Mgaete2905/TEI201-Grupo-3/hardware/esquemas/esquema_prototipo_1.png

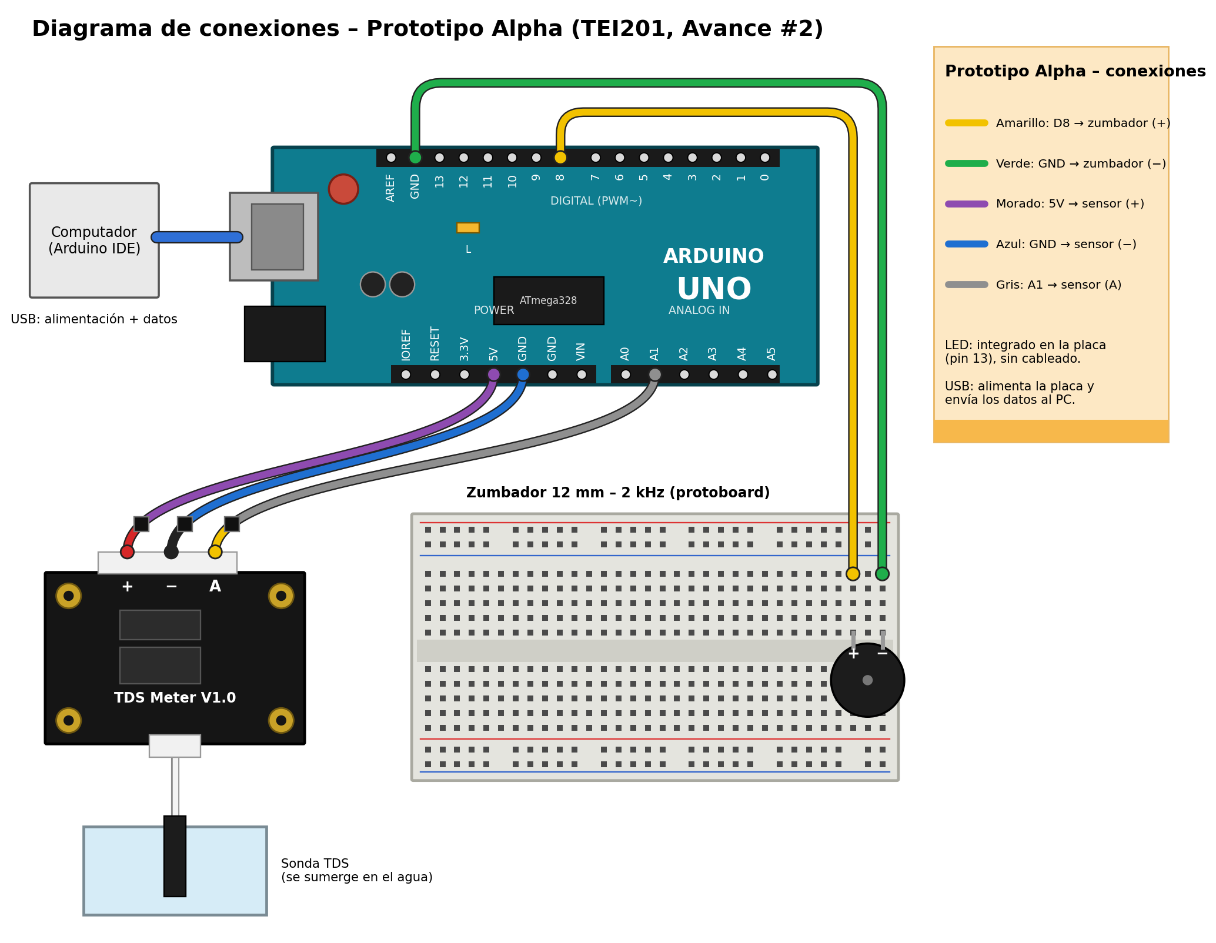
hardware/esquemas/esquema_prototipo_1.png
