Mgaete2905/TEI201-Grupo-3/diseno_3d/fusion360/ensamble_nodo.step

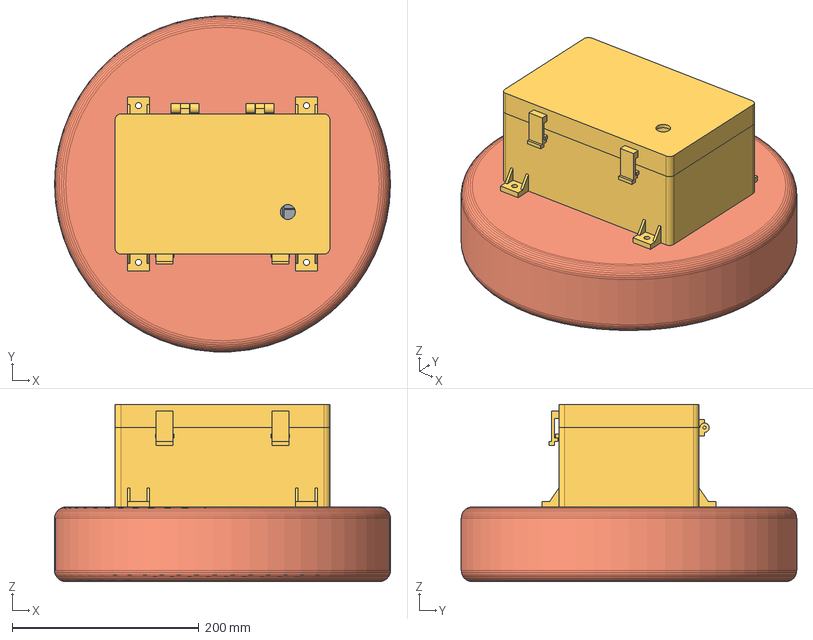
[picture p13: CAD file, 2026-10-26]
diseno_3d/fusion360/ensamble_nodo.step
360.0 x 359.5 x 190.0 mm
cofre_base
tapa
bandeja
boya_plana
ref_Arduino_Uno
ref_Protoboard_400
ref_Portapilas_2x18650
ref_Placa_TDS
ref_Silica_gel
ref_ESP32
