Mgaete2905/TEI201-Grupo-3/diseno_3d/fusion360/bandeja.step

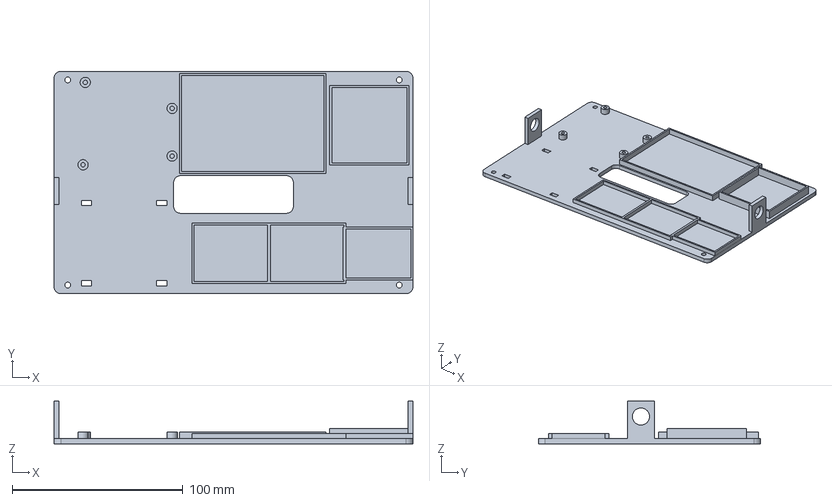
[picture p14: CAD file, 2026-10-26]
diseno_3d/fusion360/bandeja.step
210.0 x 130.0 x 25.0 mm
