Mgaete2905/TEI201-Grupo-3/diseno_3d/fusion360/tapa.step

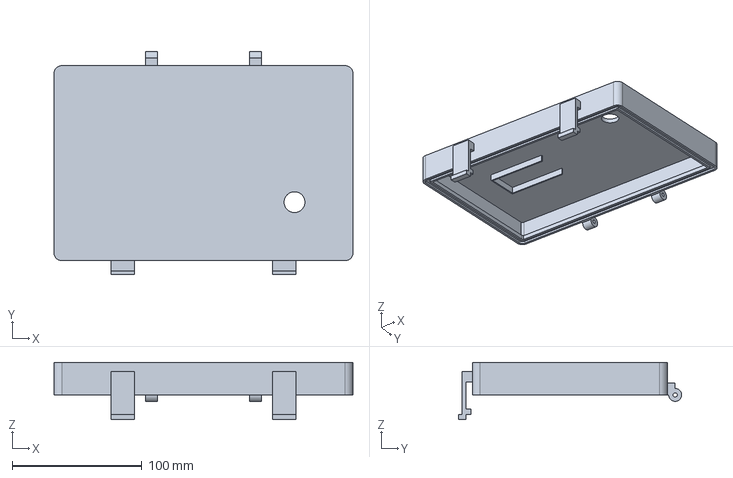
[picture p15: CAD file, 2026-10-26]
diseno_3d/fusion360/tapa.step
230.0 x 171.7 x 44.0 mm
