Mgaete2905/TEI201-Grupo-3/diseno_3d/fusion360/cofre_base.step

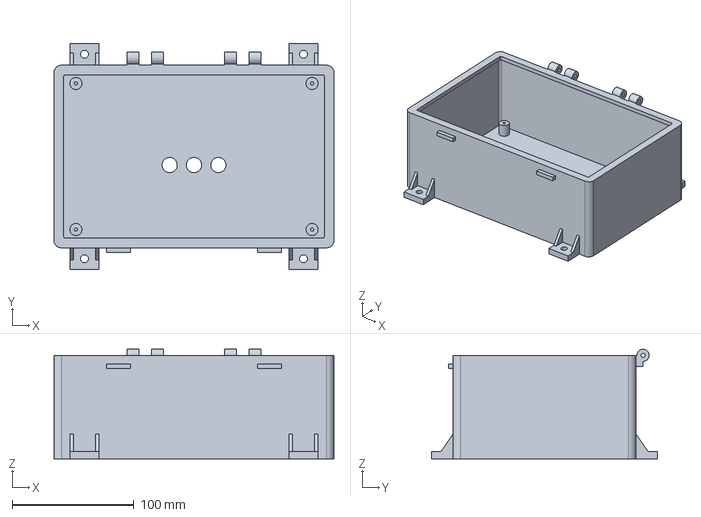
[picture p16: CAD file, 2026-10-26]
diseno_3d/fusion360/cofre_base.step
230.0 x 186.0 x 90.0 mm
