Mgaete2905/TEI201-Grupo-3/diseno_3d/fusion360/boya_plana.step

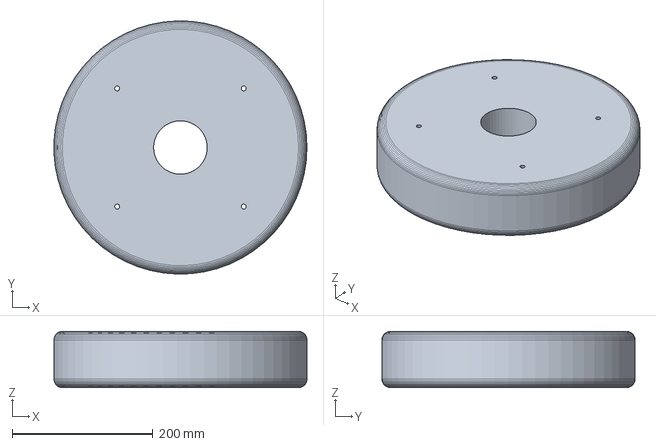
[picture p17: CAD file, 2026-10-26]
diseno_3d/fusion360/boya_plana.step
359.7 x 359.9 x 80.0 mm
