Mgaete2905/TEI201-Grupo-3/(list of files, cad)

Other CAD files:
diseno_3d/fusion360/imprimir_cofre_base.stl
diseno_3d/fusion360/imprimir_tapa.stl
diseno_3d/fusion360/imprimir_bandeja.stl
