Mgaete2905/TEI201-Grupo-3/diseno_3d/planos/planos_encapsulado.pdf

## Nodo flotante TDS · Encapsulado

Pieza: Conjunto | Material: varios
Escala sin escala · unidades mm | TEI201 UAI · 18-10-2026 · Hoja 1/4

# Conjunto general y lista de materiales

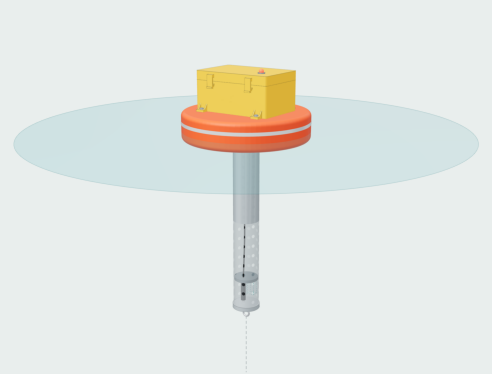
[picture p18: figure]

Medidas generales: cofre 230 × 150 × 110 (186 de ancho con orejas) · boya Ø360 × 80 · tubo Ø75 × 500 · alto total ≈ 690 · electrónica sobre la línea de flotación.

Pos. | Componente | Cant. | Especificación
1 | Cofre (base) | 1 | Impreso PETG/ASA, 4 perímetros, 100 % relleno
2 | Tapa con bisagra y pestillos | 1 | Impresa PETG/ASA, se imprime boca abajo
3 | Bandeja | 1 | Impresa PETG o PLA (zona seca)
4 | Empaque de cierre | 0,75 m | Cordón silicona/EPDM Ø4 (o burlete EPDM 4 mm)
5 | Prensaestopas PG7 IP68 | 3 | Cable Ø3–6,5; 2 con tapón ciego
6 | Piloto LED estanco 16 mm | 1 | IP67, versión 5 V, con tuerca y junta
7 | Tornillo M3 × 8 autorroscante | 8 | 4 bandeja + 4 Arduino (acero inox.)
8 | Tornillo M3 × 35 + tuerca autoblocante | 2 | Ejes de bisagra (acero inox.)
9 | Perno M6 × 100 + tuerca + golillas | 4 | Fijación a la boya (acero inox. 316)
10 | Bridas plásticas 2,5 × 100 | 2 | Sujetan el portapilas
11 | Cinta doble faz | 1 | Bajo el portapilas y la protoboard
12 | Sílica gel | 1 | Bolsa 10–20 g, cambiar al abrir
13 | Boya plana Ø≈360 | 1 | Comprada (HDPE/espuma) y perforada
14 | Tubo PVC hidráulico Ø75 | 0,5 m | Perforado Ø10 en la parte baja

Electrónica (no impresa): Arduino Uno, protoboard 400, portapilas 2×18650, placa TDS, ESP32, sonda TDS.

# Cofre (base)

### PLANTA (vista superior)

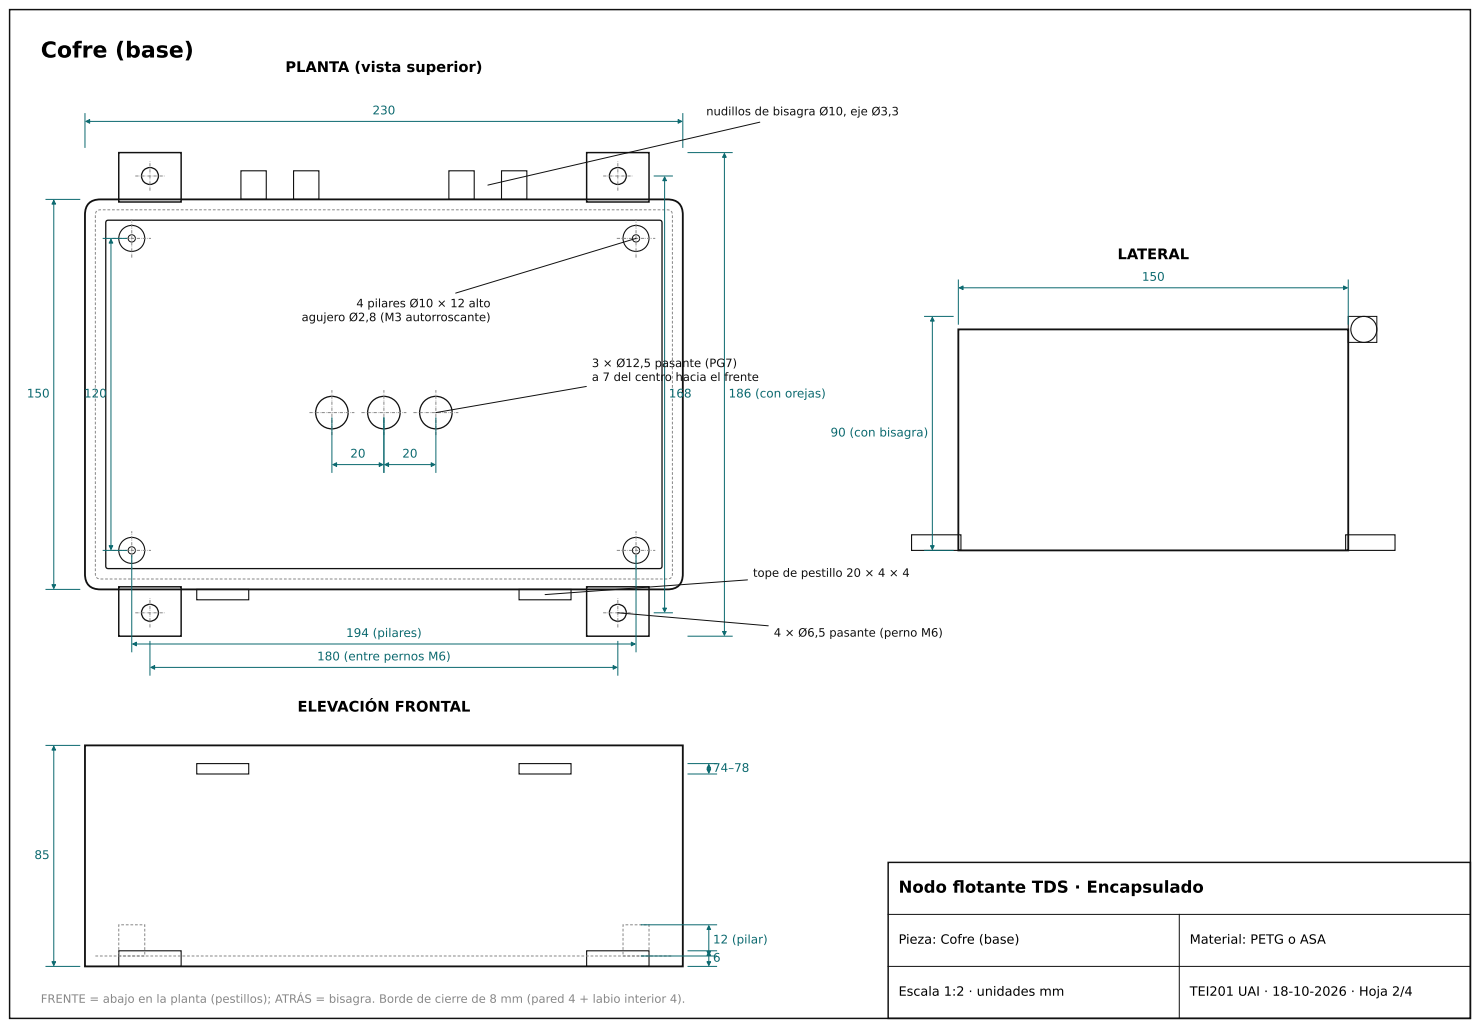
[picture p19: page 2]
Pieza: Cofre (base); Material: PETG o ASA; Escala 1:2 · unidades mm; TEI201 UAI · 18-10-2026 · Hoja 2/4; 186 (con orejas); 180 (entre pernos M6); 194 (pilares); 4 × Ø6,5 pasante (perno M6); 4 pilares Ø10 × 12 alto agujero Ø2,8 (M3 autorroscante); ELEVACIÓN FRONTAL; 12 (pilar); LATERAL; 90 (con bisagra)

nudillos de bisagra Ø10, eje Ø3,3

3 × Ø12,5 pasante (PG7)
a 7 del centro hacia el frente

tope de pestillo 20 × 4 × 4

Nodo flotante TDS · Encapsulado

FRENTE = abajo en la planta (pestillos); ATRÁS = bisagra. Borde de cierre de 8 mm (pared 4 + labio interior 4).

# Tapa con bisagra, pestillos y ranura de empaque

### PLANTA (vista superior)

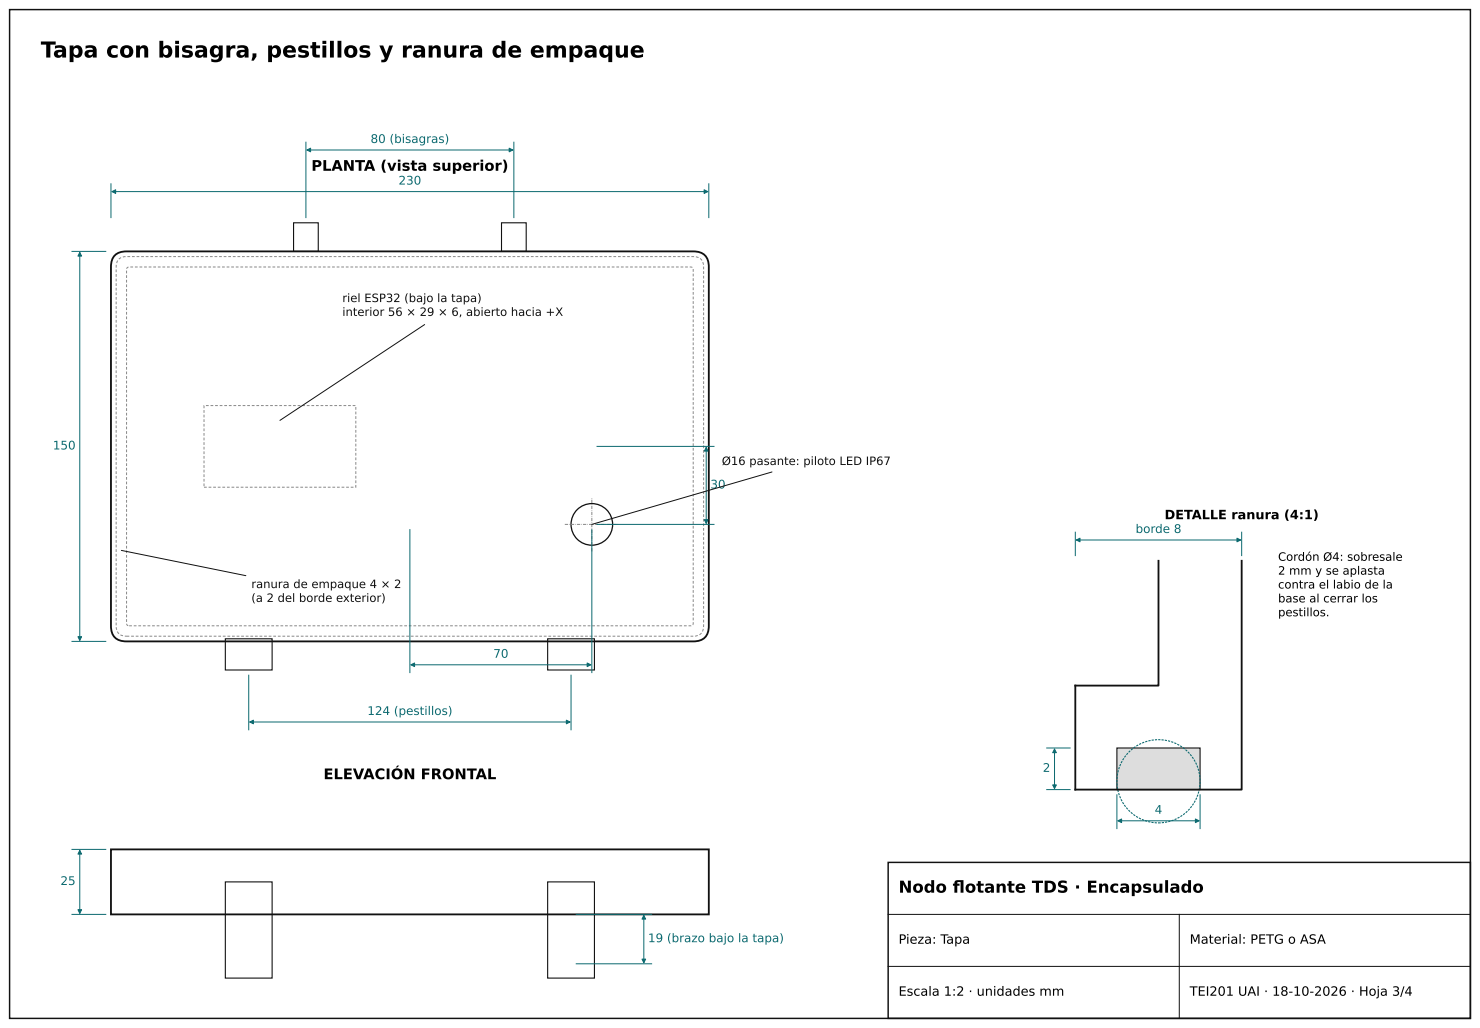
[picture p20: page 3]
Pieza: Tapa; Material: PETG o ASA; 124 (pestillos); 80 (bisagras); ELEVACIÓN FRONTAL; DETALLE ranura (4:1); borde 8

riel ESP32 (bajo la tapa)
interior 56 × 29 × 6, abierto hacia +X

Ø16 pasante: piloto LED IP67

Cordón Ø4: sobresale
2 mm y se aplasta
contra el labio de la
base al cerrar los
pestillos.

ranura de empaque 4 × 2
(a 2 del borde exterior)

Nodo flotante TDS · Encapsulado

19 (brazo bajo la tapa)

# Bandeja removible y fijación de componentes

### PLANTA (vista superior)

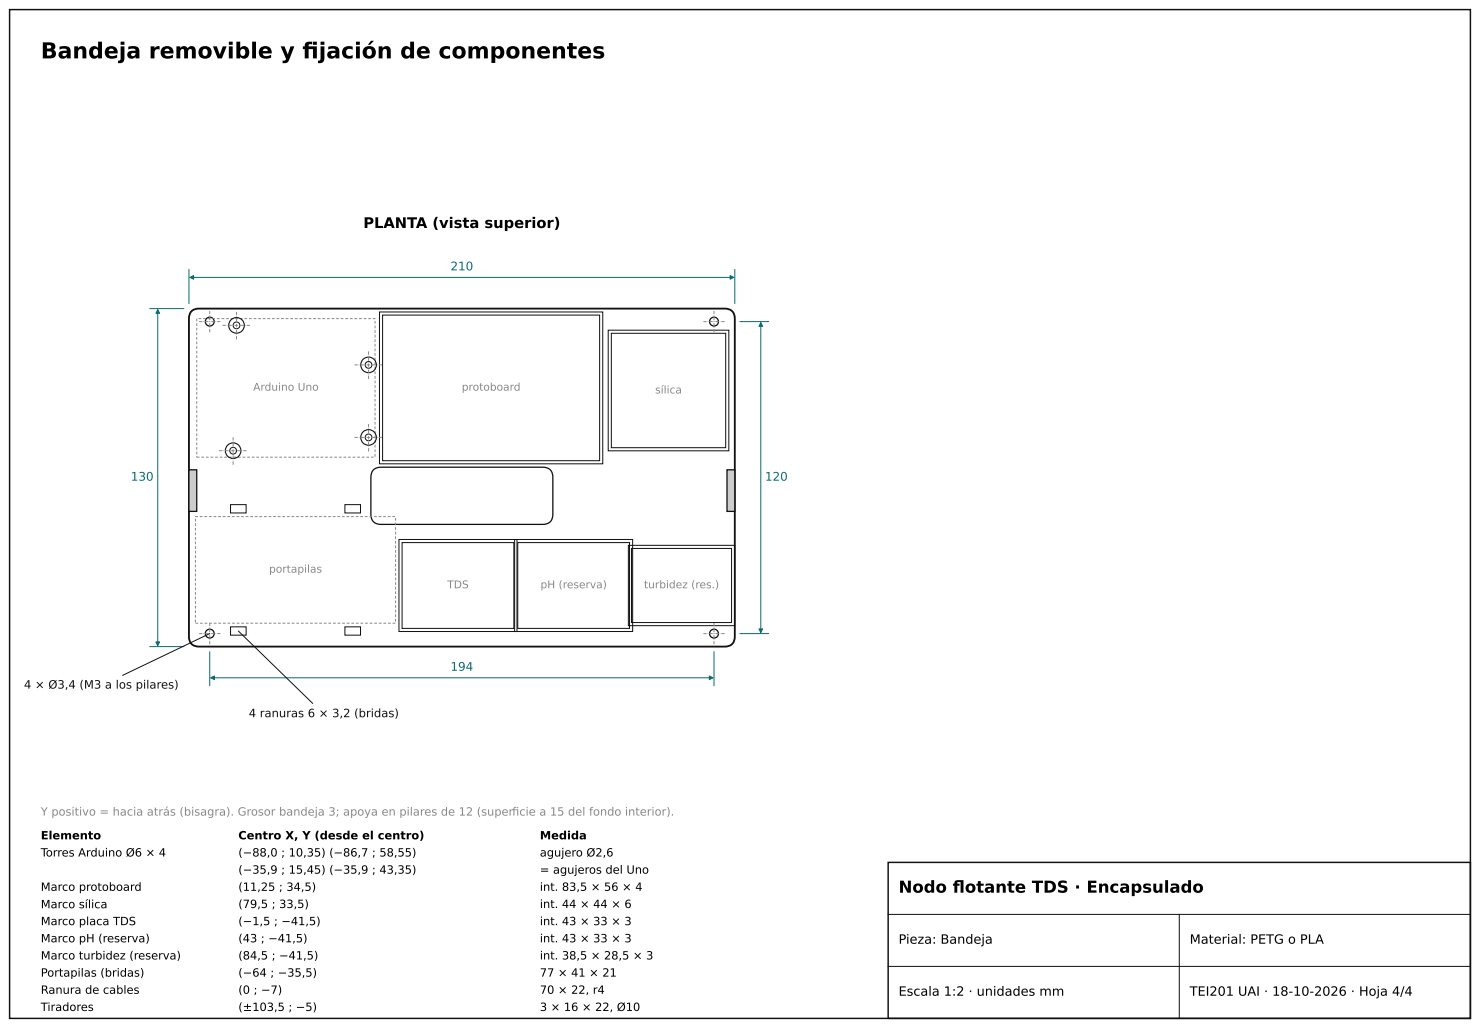
[picture p21: page 4]
Pieza: Bandeja; Material: PETG o PLA; protoboard; sílica; TDS; pH (reserva); turbidez (res.); portapilas; Arduino Uno; 4 × Ø3,4 (M3 a los pilares); 4 ranuras 6 × 3,2 (bridas); Elemento; Centro X, Y (desde el centro); Medida; Torres Arduino Ø6 × 4; agujero Ø2,6; = agujeros del Uno; Marco protoboard; int. 83,5 × 56 × 4; Marco sílica; int. 44 × 44 × 6; Marco placa TDS; int. 43 × 33 × 3; Marco pH (reserva); Marco turbidez (reserva); int. 38,5 × 28,5 × 3; Portapilas (bridas); Ranura de cables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

Y positivo = hacia atrás (bisagra). Grosor bandeja 3; apoya en pilares de 12 (superficie a 15 del fondo interior).

Nodo flotante TDS · Encapsulado
