Mgaete2905/TEI201-Grupo-3/testing/evidencias/Grafico_Prueba_Sal.png

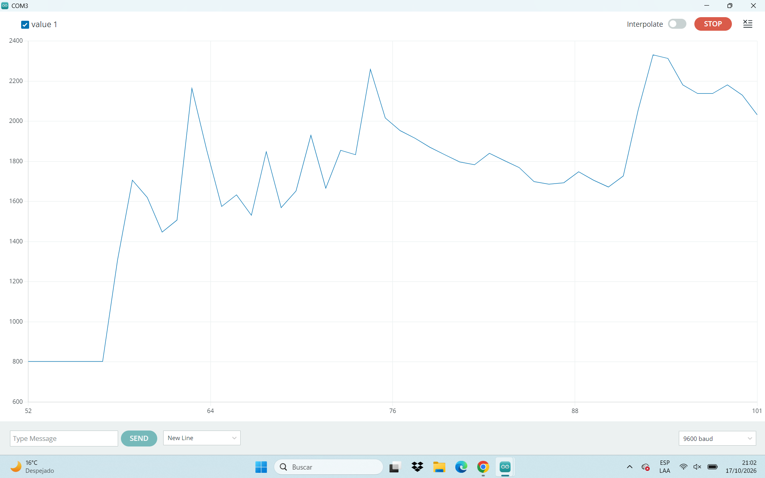
testing/evidencias/Grafico_Prueba_Sal.png
