Mgaete2905/TEI201-Grupo-3/hardware/esquemas/montaje_general_prototipo_1.jpeg

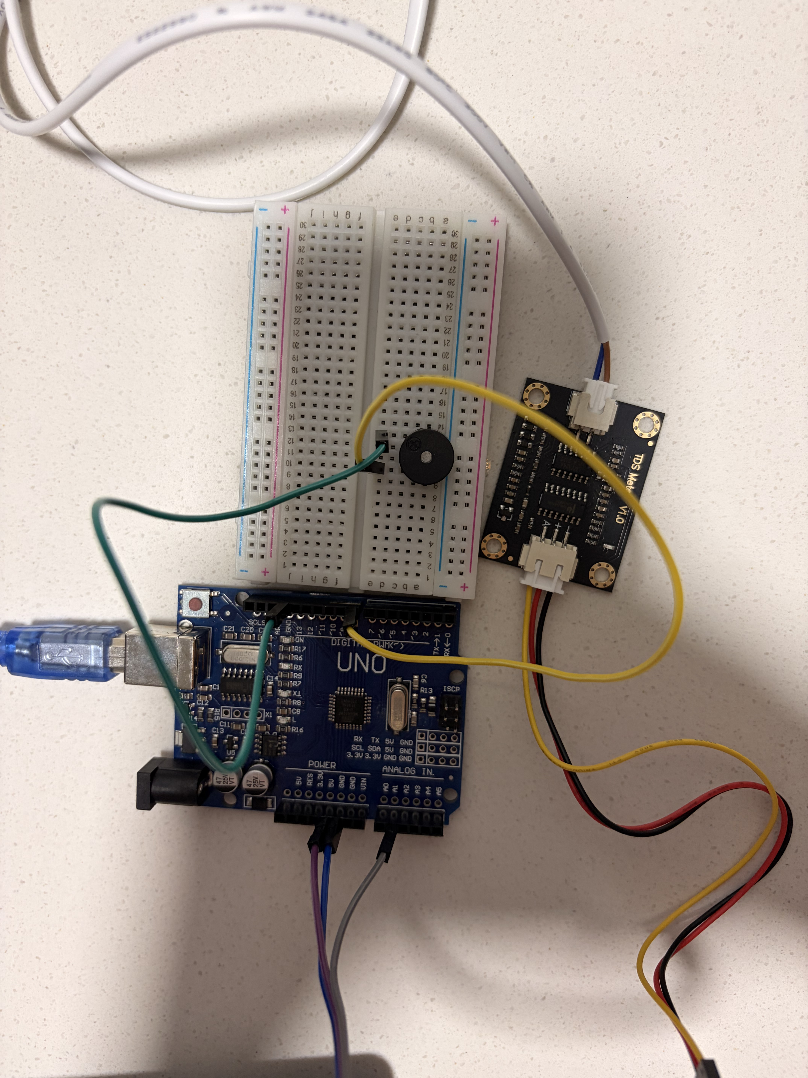
hardware/esquemas/montaje_general_prototipo_1.jpeg
